jacek13/ATmegaGameConsole/resources/Schematics/MegaPocketDIP_prototype_final.pdf

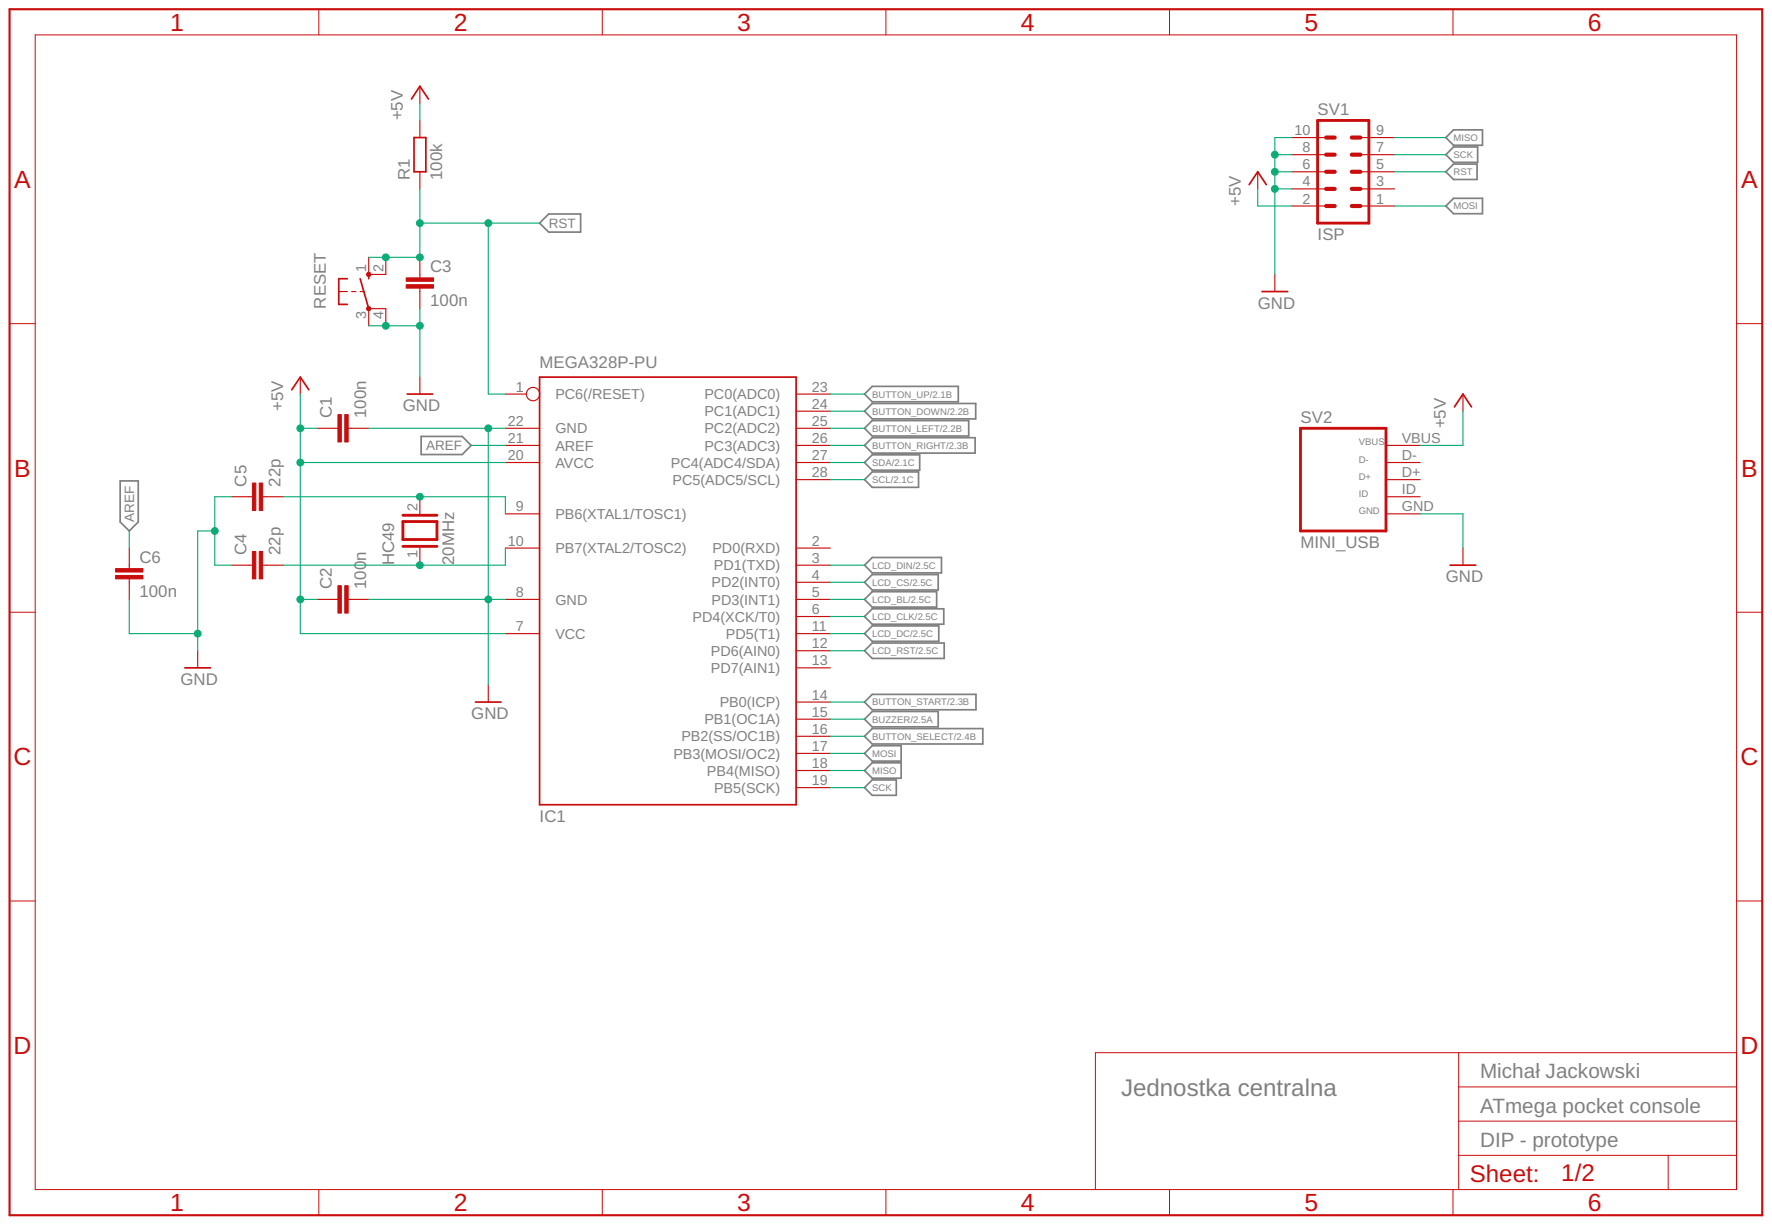
[picture p2: page 1]

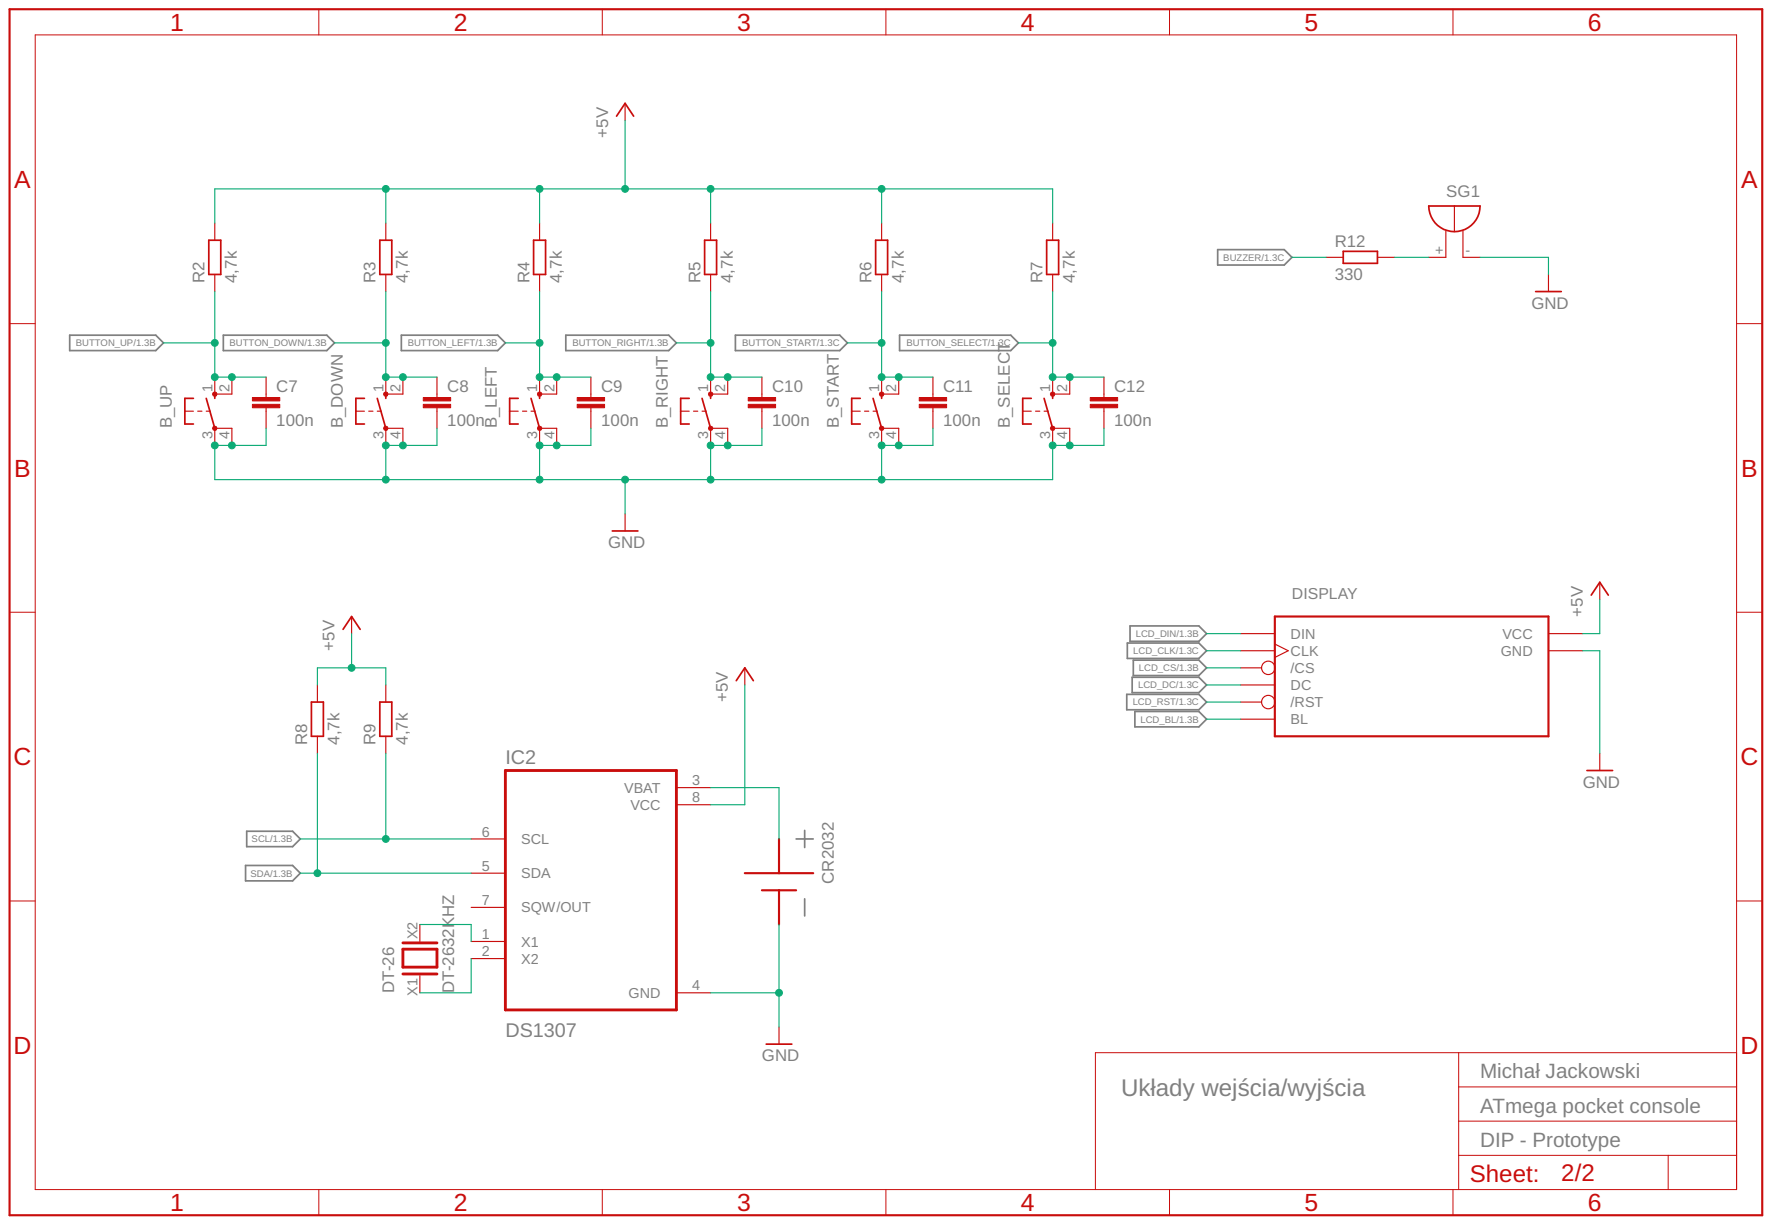
[picture p3: page 2]
