jacek13/ATmegaGameConsole/resources/Schematics/MegaPocketSMD_ver_4.pdf

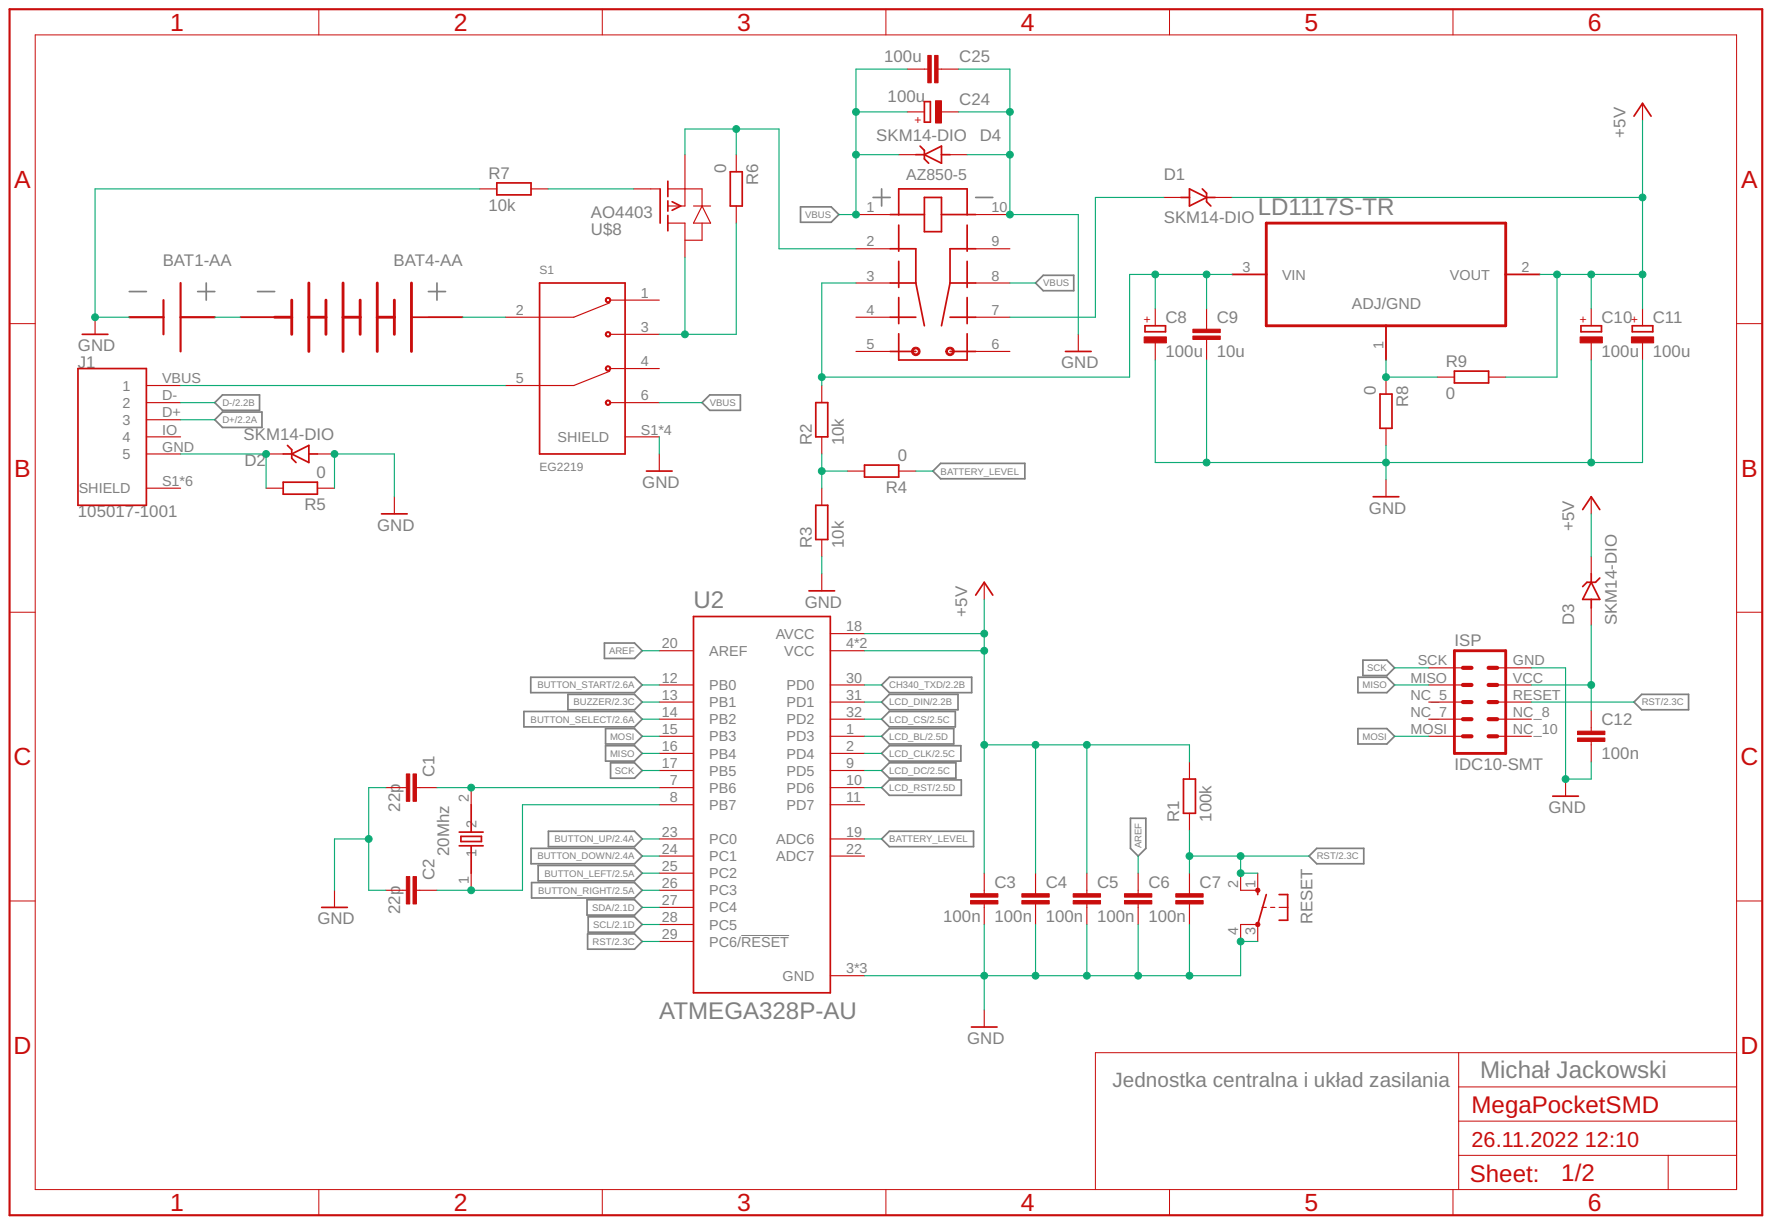
[picture p4: page 1]

Jednostka centralna i układ zasilania

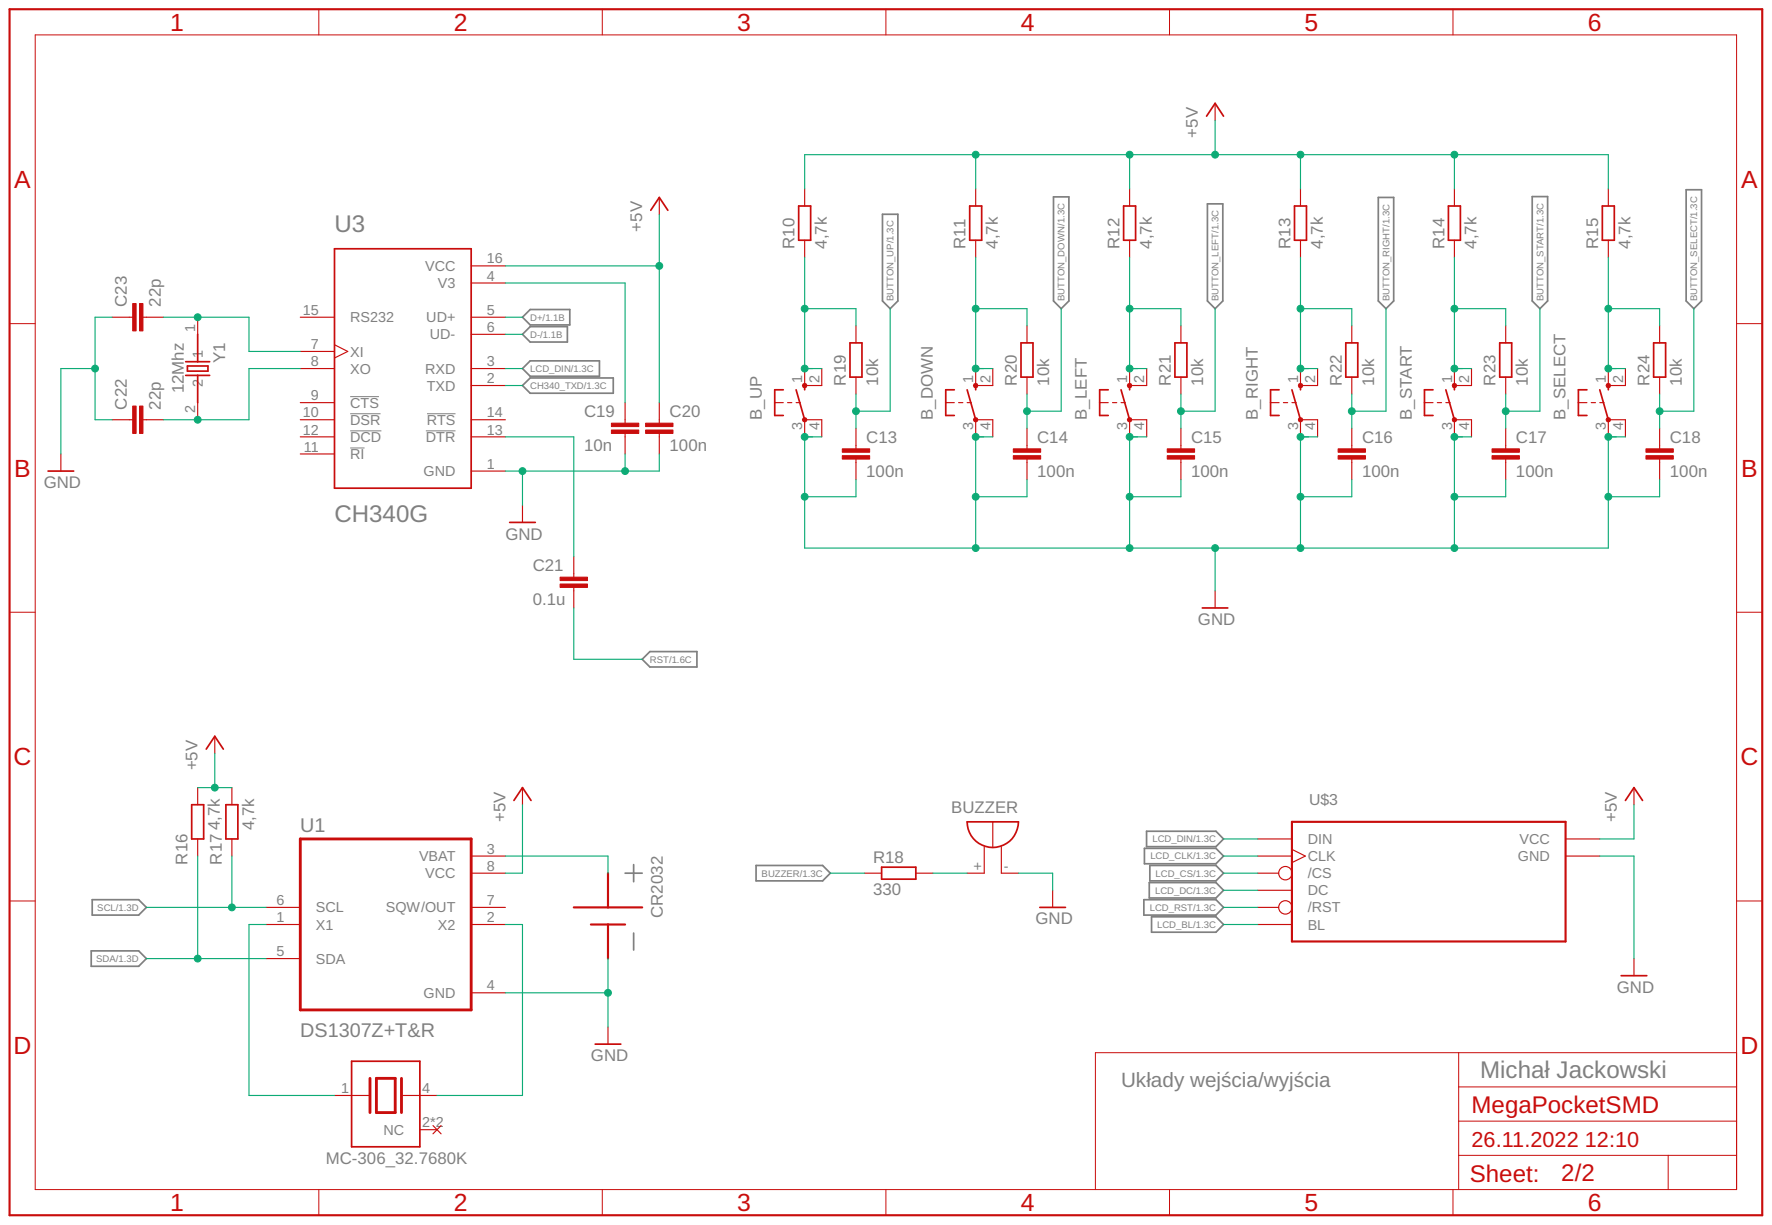
[picture p5: page 2]
