jacek13/ATmegaGameConsole/resources/PCB/MegaPocketDIPprototype_PCB_without_polygon.pdf

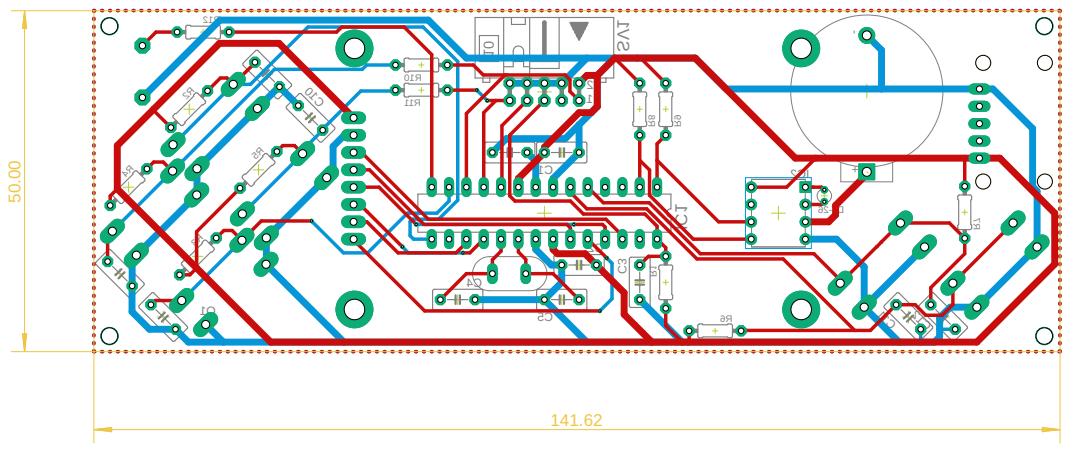
[picture p6: page 1]
