jacek13/ATmegaGameConsole/resources/PCB/MegaPocketSMD_PCB_B_Polygon_ver_4.pdf

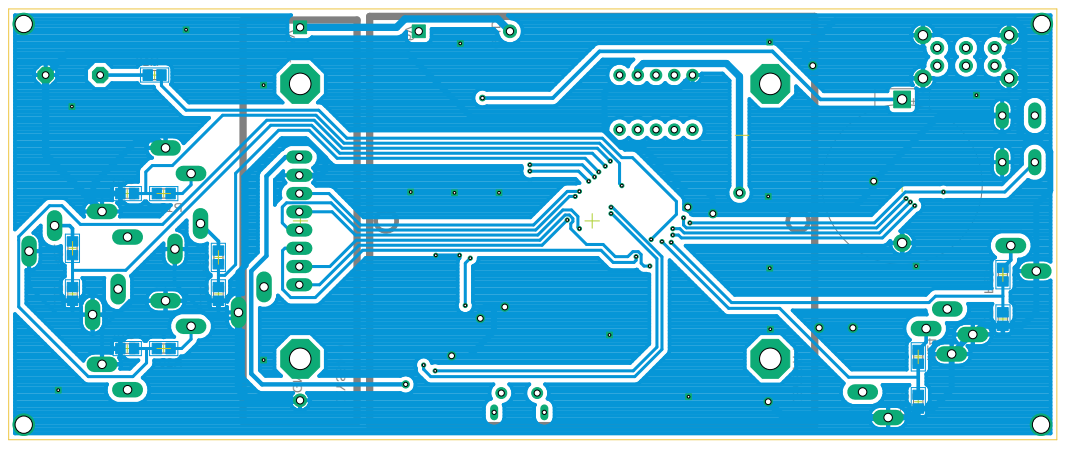
[picture p7: page 1]
