jacek13/ATmegaGameConsole/resources/PCB/MegaPocketSMD_PCB_T_Polygon_ver_4.pdf

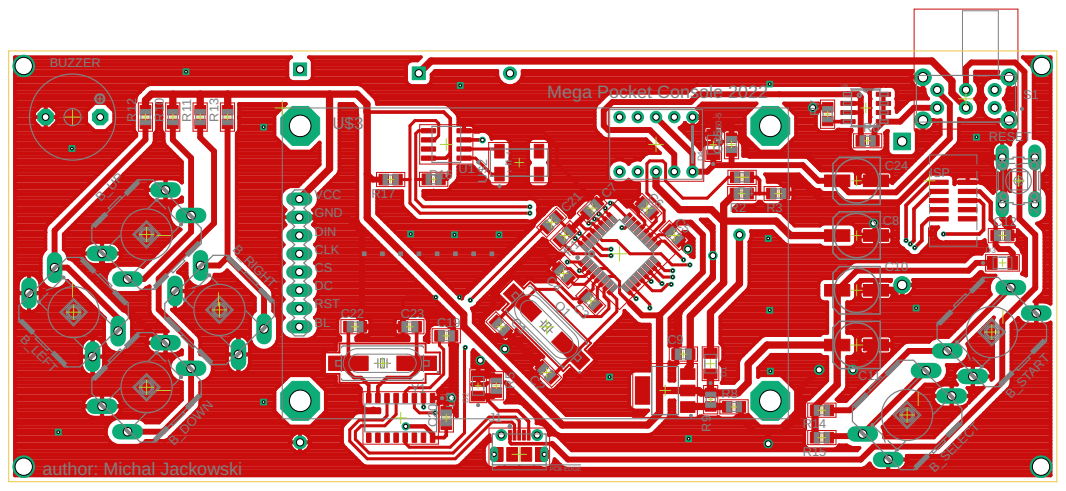
[picture p8: page 1]
