jacek13/ATmegaGameConsole/resources/PCB/MegaPocketSMD_PCB_TB_ver_4.pdf

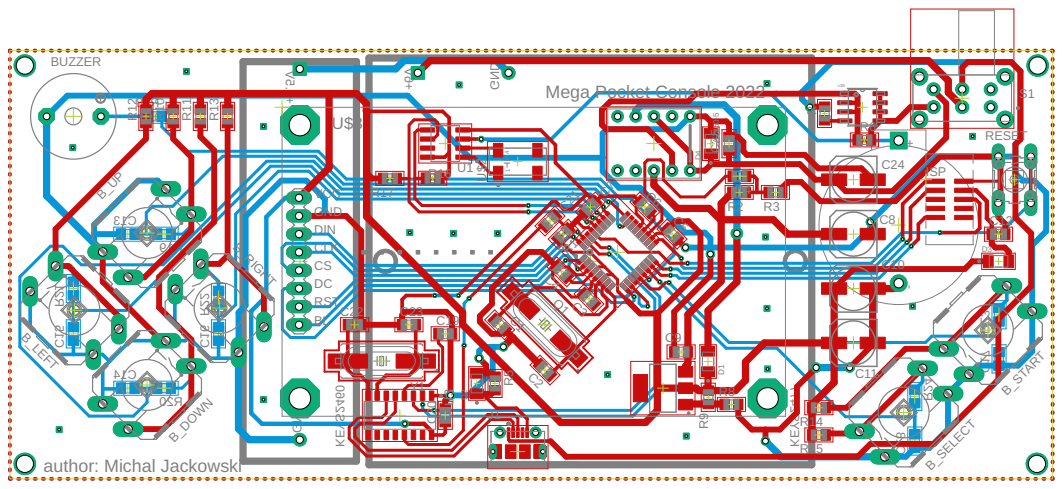
[picture p9: page 1]
