jacek13/ATmegaGameConsole/(commit log)

2022-11-07 Added input handling (6 micro-switches, external pull-up resistor). Added better drawing sequence + bug fixes.
    [input.c, input.h, main.c]
2022-11-21 New defenition for input pins (Input buttons). Added new demos.
2022-11-27 Added menu structure and functions for it. Problem with lack of memory at stack. All strings must be moved to progmem.
    [main.c]
2022-11-28 Added new input handling. Fixed Menu structure. Resignation from dynamic string allocation in favor of placing text in FLASH memory.
    [input.c, input.h, main.c]
2022-11-29 Fixed menu + Code refactoring
    [main.c]
2022-12-02 Refactoring + fixes. Combine Menu structure with demos and games. Added resources folder and new Readme.md
    [display.c]
2022-12-18 Version for 20Mhz edition. Some problem with PWM on BL pin occurred (TODO fix). Added new settings for font color. Added offset for tiles in Tetris.
    [config.h, ili9341.c, main.c]
2023-01-19 Added device presentation.
